Nemo17043010/greenpak_addon/hw/greenpak_addon.pdf

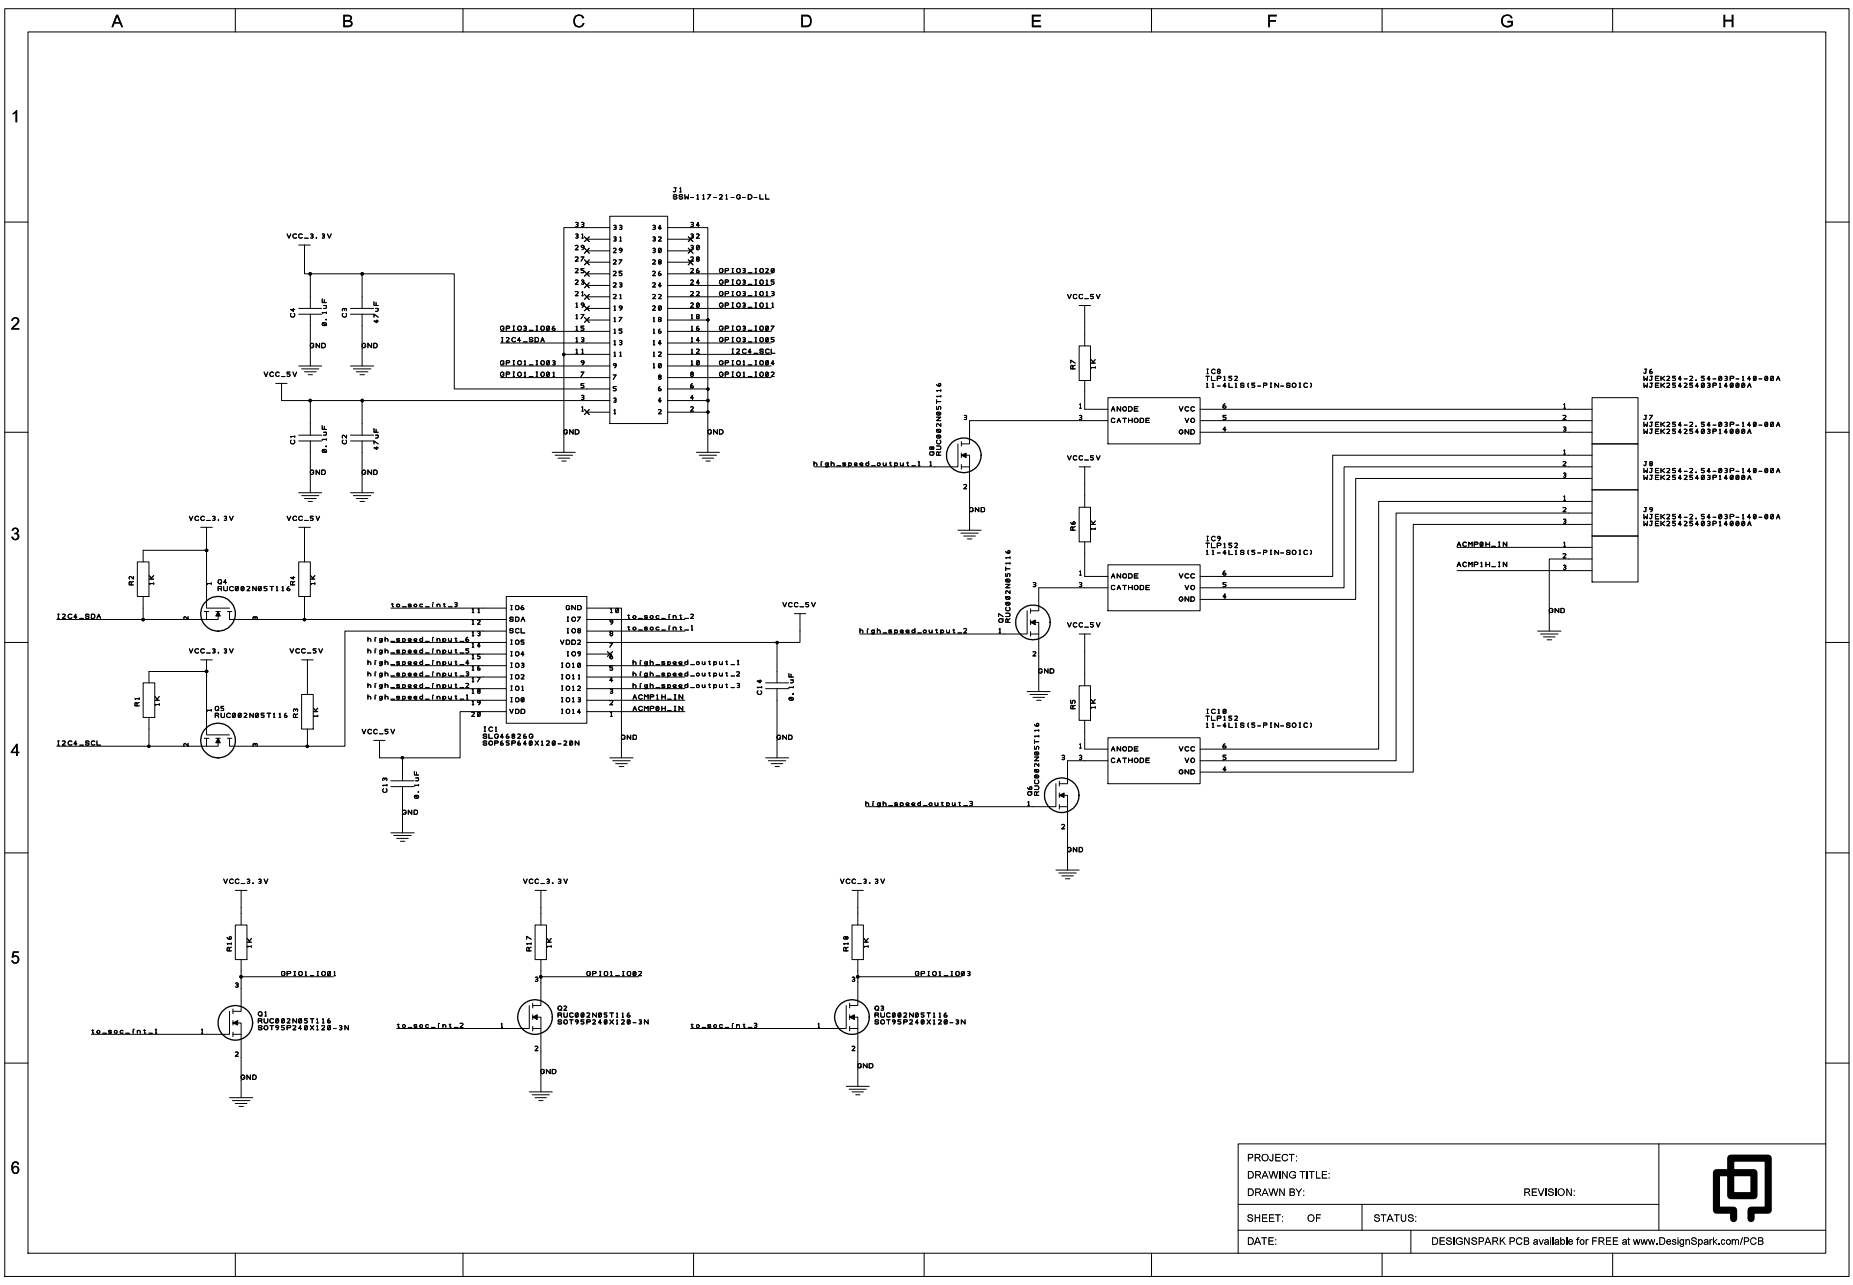
[picture p1: page 1]

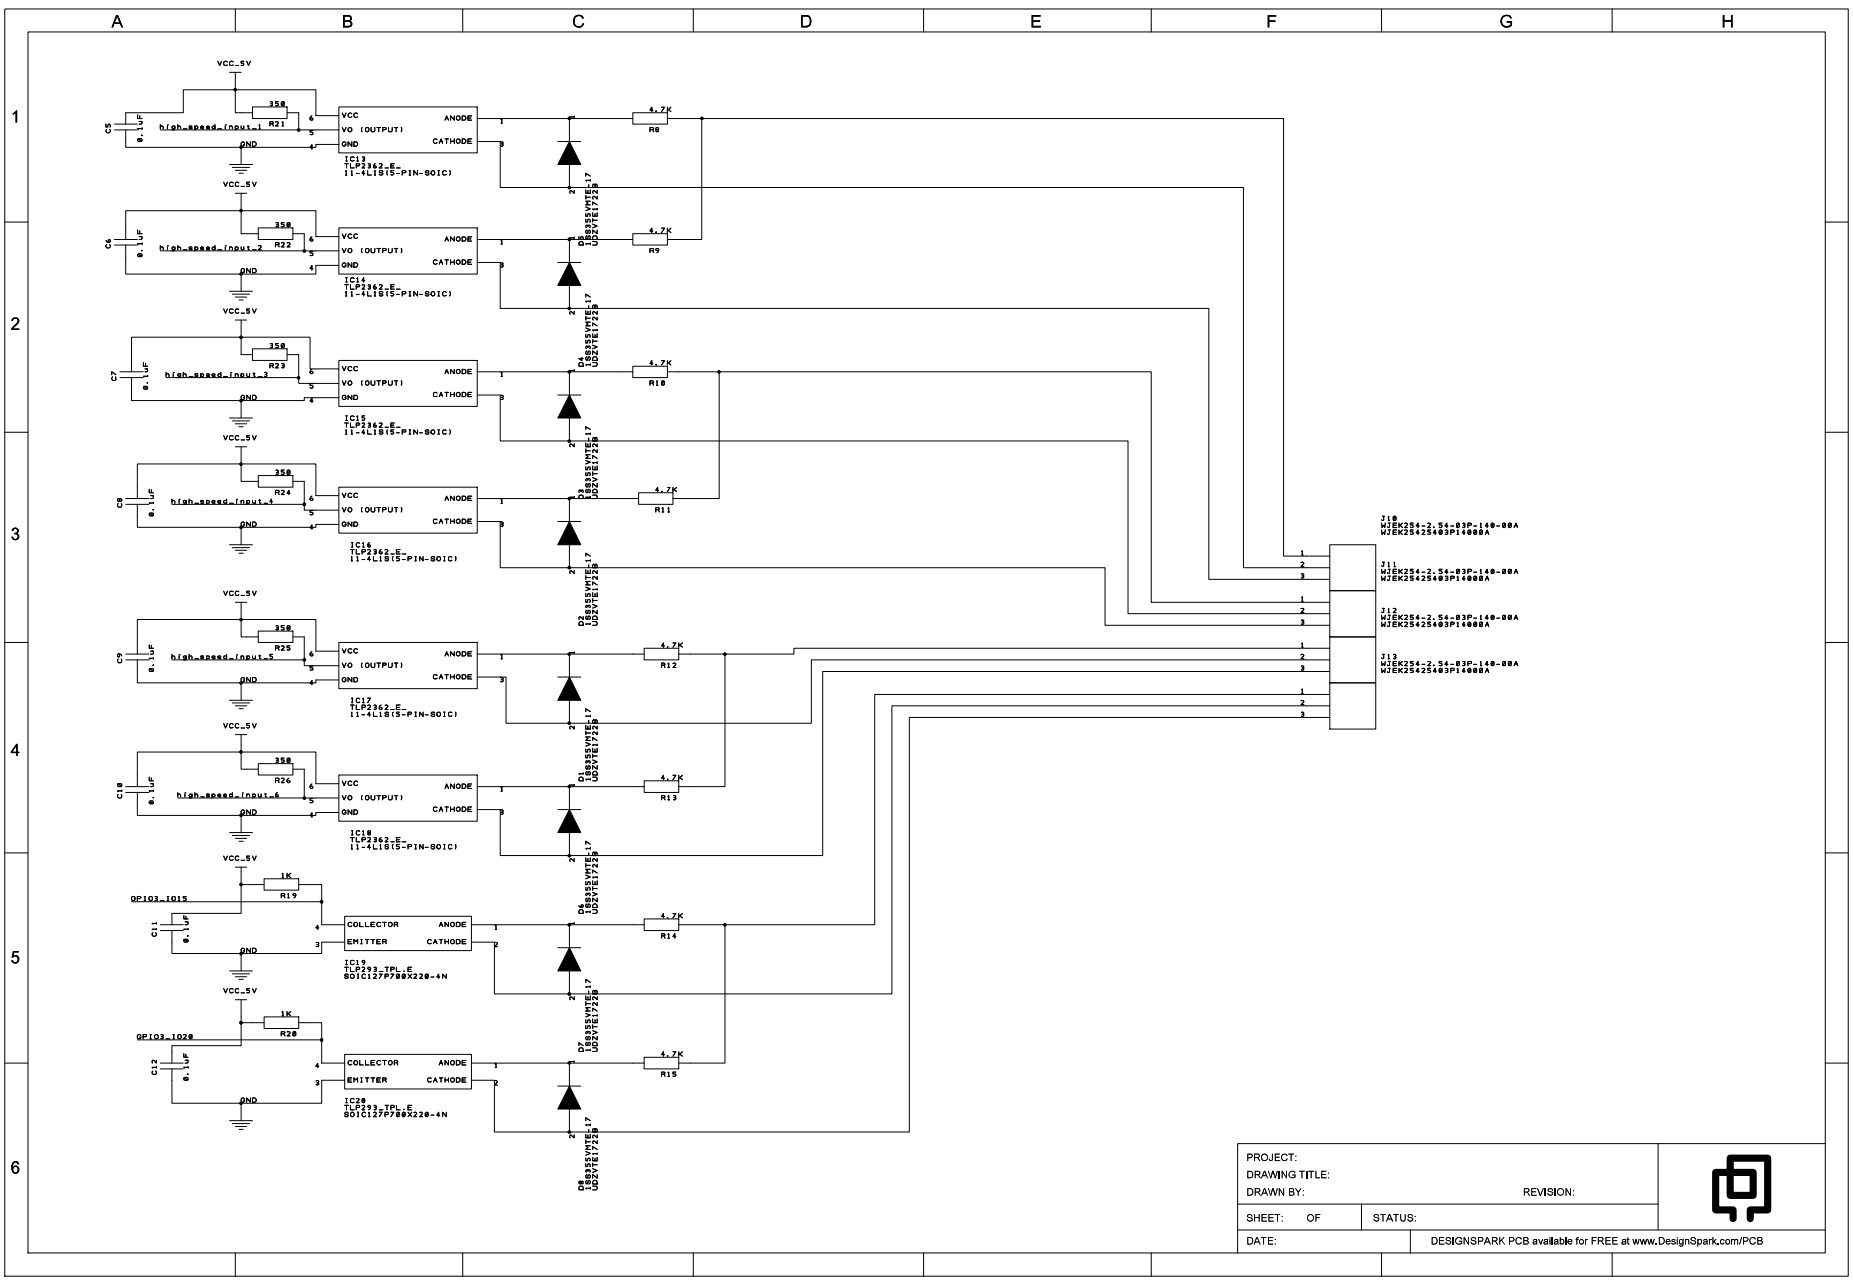
[picture p2: page 2]
