Nemo17043010/greenpak_addon/(list of files, drawings)

Other design files:
hw/greenpak_addon.pcb
