Nemo17043010/greenpak_addon/(commit log)

2023-10-01 Added prototype declaration
2023-10-07 remove extra printf
2023-10-10 Update README.md
    書き込んだ回路についての説明
2023-10-10 Added greenpak image
    [SLG46824_6_pulse_cnt.csv]
